Nsea261168/gongchuang-car-archive/README.md

# 工创小车差速方案（项目归档）

项目原本面向工创赛智能救援赛道。由于队内协调及其他现实原因，小队最终决定弃赛。现将由我负责完成的 STM32 固件、整车结构和方案开源。

> **项目状态：** 已停止主动维护。差速版整车完成过实车验证，能够越过减速带、推动所有物块；第一版麦克纳姆轮方案因整车超重被淘汰，未进行实装测试。其他功能的实际完成度请以源码和 `firmware/stm32h7/Docs/` 中的文档为准。

## 仓库内容

| 目录 | 内容 | 状态 |
| --- | --- | --- |
| `firmware/stm32h7/` | 基于 STM32H723 的主控固件、Keil 工程和开发文档 | 部分功能完成实车验证，具体见项目文档 |
| `mechanical/工创小车差速方案.f3z` | Autodesk Fusion 360 差速底盘整车装配体 | 已实装并完成基础通行、推物测试 |
| `mechanical/工创小车麦克纳姆.f3z` | 第一版四驱麦克纳姆轮整车装配体 | 因超重放弃，未实装测试 |

## 重要说明

- 机械结构、硬件选型、固件开发和整车测试主要由我一人完成。受时间和个人能力所限，Fusion 草图约束、固件工程结构及数据调度仍有不完善之处。欢迎通过 Issue 或邮件指出问题、交流改进方案。
- 为尽快完成原型验证，本项目使用的控制板、驱动板和传感器均为成品模块。参赛者应自行核对当届比赛规则，并按要求完成自主硬件设计，不能将本归档直接视为合规参赛方案。
- 本仓库是停止开发后的工程归档，不保证可以直接参赛、量产或长期稳定运行。上电和实车测试前，请先架空车轮，并确认急停、通信超时、执行机构限位、方向和速度限制全部有效。
- 仓库公开不自动改变各文件原有的许可状态。固件目录保留了原仓库的 `LICENSE` 及第三方组件许可证；历史文档对许可证的描述存在不一致，复用前请自行核对权利归属。
- 两份整车装配体目前没有单独声明许可。未经权利人另行授权，不应默认获得商业使用或再分发权。
- 如有问题，可发送邮件至 `501621243@qq.com`，或添加同号 QQ 交流。

## 项目方案与硬件配置

项目最终采用成本和性能较为均衡的方案：以激光雷达进行定位感知，以单摄像头运行 YOLO 完成视觉识别，并使用四轮差速底盘完成运动与推物。

主要硬件包括：

- 主控：达妙 STM32H723 控制板；
- 电机：MG513 系列减速电机；
- 车轮：65 mm 橡胶轮；
- 驱动：松甲科技四路电机驱动板；
- 雷达：LD06 激光雷达；
- 遥控调试：驱动板可连接 JDY-31 蓝牙模块，用于快速验证机械结构与底盘运动。

固件的架构设计、业务逻辑开发和文档整理大量使用了 ChatGPT 5.6 Sol 辅助完成；ST 官方 CMSIS/HAL、设备驱动及其他第三方组件仍归各自原作者所有，不应视为 AI 原创内容。

## 固件快速入口

- Keil 工程：`firmware/stm32h7/MDK-ARM/CtrBoard-H7_FDCAN.uvprojx`
- CubeMX 配置：`firmware/stm32h7/CtrBoard-H7_FDCAN.ioc`
- 文档入口：`firmware/stm32h7/Docs/README.md`
- 开发说明：`firmware/stm32h7/Docs/DEVELOPMENT_GUIDE.md`
- 项目架构：`firmware/stm32h7/Docs/PROJECT_ARCHITECTURE.md`
- 项目规则：`firmware/stm32h7/Docs/PROJECT_RULES.md`

固件采用裸机协作式调度，包含 CAN/FDCAN、UART、IMU、激光雷达、底盘电机、舵机、LCD、按键服务和任务状态机等模块。实际接线、调度约束、测试方法和安全边界，请优先阅读 `firmware/stm32h7/Docs/`。

## 整车装配体

仓库保留了两条结构路线：

1. **差速方案**：项目最终采用的版本，完成过整车装配以及基础越障、推物测试。
2. **麦克纳姆轮方案**：项目第一版结构废案。该版本因整车重量超出预期而没有进入实装测试，仅用于展示早期设计思路和方案演进。除非重新核算重量、结构强度、重心和驱动能力，否则不建议直接加工使用。

`.f3z` 是 Autodesk Fusion 360 归档格式，可在 Fusion 中通过“文件 → 打开/上传”导入。模型由 Git LFS 管理，克隆仓库前请先安装 Git LFS：

```bash
git lfs install
git clone https://github.com/Nsea261168/gongchuang-car-archive.git
```

## 方案演进与反思

我曾经为这个项目设想并尝试过多种路线：四驱麦克纳姆轮、惯性导航、深度相机，以及最终采用的激光雷达定位与单摄像头 YOLO。现在看来，双路正交 ToF 激光测距配合陀螺仪，也许会是一条成本更低、效果更好的方案。

## 致后来者

- 我对工创赛抱有很大的热情，但是很遗憾，直至校赛测评我的队友几乎做出了0贡献，因此不得不选择弃赛，不过与此同时，这次“失败”的竞赛经历也给了我许多启发。对于本项目，我所掌握的技术能力也许还不及这个项目所需要的水平。比如通过ROS操作系统节点+话题的方式来管理所有传感器比裸机操作串口通讯调度传感器数据更贴合本项目的需求，然而我对linux相关开发一无所知，于是选择了更熟悉的stm32裸机操作。
- 在一开始，我就隐约预料到了这件事的结果，可是在电赛中失败的我又迫切的想要一个名次来证明自己，于是我不断忍受队友的不作为，默默揽下更多的负责部分，直到最后弃赛。我想我们应该先想明白竞赛的目的是什么，而不是为了竞赛而竞赛。经历本项目的失败之后，我决定系统学习ros2系统，认真的考虑如何协调人，如何对待竞赛。

- 欢迎阅读、研究，在明确许可范围内继续完善它。愿后来者带着更完整的团队、更充分的准备和更坚定的执行，把我没有走完的路继续走下去。如果我的成果能帮到大家，那么我的心血也算没有白流。
