Nsea261168/gongchuang-car-archive/(list of files, cad)

Other CAD files:
mechanical/工创小车差速方案.f3z
mechanical/工创小车麦克纳姆.f3z
