Nsea261168/gongchuang-car-archive/firmware/stm32h7/Core/Inc/main.h

#define POWER_OUT2_EN_Pin GPIO_PIN_13
#define POWER_OUT2_EN_GPIO_Port GPIOC
#define POWER_OUT1_EN_Pin GPIO_PIN_14
#define POWER_OUT1_EN_GPIO_Port GPIOC
#define POWER_5V_EN_Pin GPIO_PIN_15
#define POWER_5V_EN_GPIO_Port GPIOC
#define USER_KEY_Pin GPIO_PIN_15
#define USER_KEY_GPIO_Port GPIOA
#define ACC_CS_Pin GPIO_PIN_0
#define ACC_CS_GPIO_Port GPIOC
#define GYRO_CS_Pin GPIO_PIN_3
#define GYRO_CS_GPIO_Port GPIOC
#define LCD_CS_Pin GPIO_PIN_15
#define LCD_CS_GPIO_Port GPIOE
#define LCD_BLK_Pin GPIO_PIN_10
#define LCD_BLK_GPIO_Port GPIOB
#define LCD_RES_Pin GPIO_PIN_11
#define LCD_RES_GPIO_Port GPIOB
#define LCD_DC_Pin GPIO_PIN_10
#define LCD_DC_GPIO_Port GPIOD
