Nsea261168/gongchuang-car-archive/firmware/stm32h7/BSP/CAN/bsp_fdcan.h

/* bsp/can: FDCAN declarations. */
#ifndef __BSP_FDCAN_H__
#define __BSP_FDCAN_H__
#include "main.h"
#include "fdcan.h"

#define hcan_t FDCAN_HandleTypeDef

void bsp_can_init(void);
void can_filter_init(void);
uint8_t fdcanx_send_data(hcan_t *hfdcan, uint16_t id, uint8_t *data, uint32_t len);
uint8_t fdcanx_receive(hcan_t *hfdcan, uint16_t *rec_id, uint8_t *buf);
void fdcan1_rx_callback(void);
void fdcan2_rx_callback(void);
void fdcan3_rx_callback(void);

#endif /* __BSP_FDCAN_H_ */
