Nsea261168/gongchuang-car-archive/(commit log)

2026-09-13 archive: publish STM32 firmware and vehicle assembly
    [工创小车差速方案.f3z]
2026-09-13 archive: add untested mecanum-wheel concept
    [工创小车麦克纳姆.f3z]
