Nsea261168/gongchuang-car-archive/(notices)

Notices in the files:
firmware/stm32h7/Core/Inc/main.h:
Copyright (c) 2024 STMicroelectronics.
All rights reserved.
This software is licensed under terms that can be found in the LICENSE file
